deets/far-telemetry-v3/dual-sx1281-carrier-board/dual-sx1281-carrier-board.step

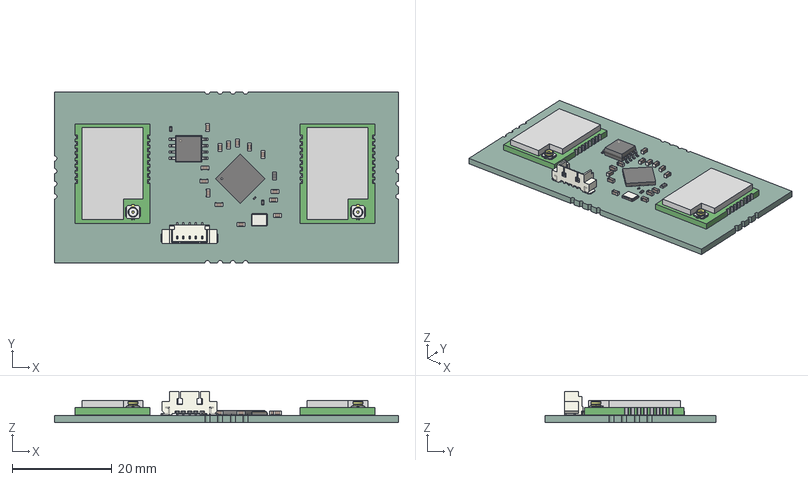
[picture p2: CAD file, 2026-10-22]
dual-sx1281-carrier-board/dual-sx1281-carrier-board.step
68.8 x 34.3 x 6.24 mm
C_0603_1608Metric x 14
Crystal_SMD_3225-4Pin_3.2x2.5mm
R_0402_1005Metric x 2
R_0603_1608Metric
QFN-56-1EP_7x7mm_P0.4mm_EP3.2x3.2mm
SOIC-8_5.3x5.3mm_P1.27mm
Folder 07 x 2
Linear Pattern 01 x 2
pads x 2
R_0201_0603Metric
Molex_53398_0571
dual-sx1281-carrier-board-unsaved-export-qZhUrT_PCB
