deets/far-telemetry-v3/dual-sx1281-carrier-board/dual-sx1281-carrier-board.kicad_pcb

## KiCad design dual-sx1281-carrier-board/dual-sx1281-carrier-board.kicad_pcb (2026-10-22)

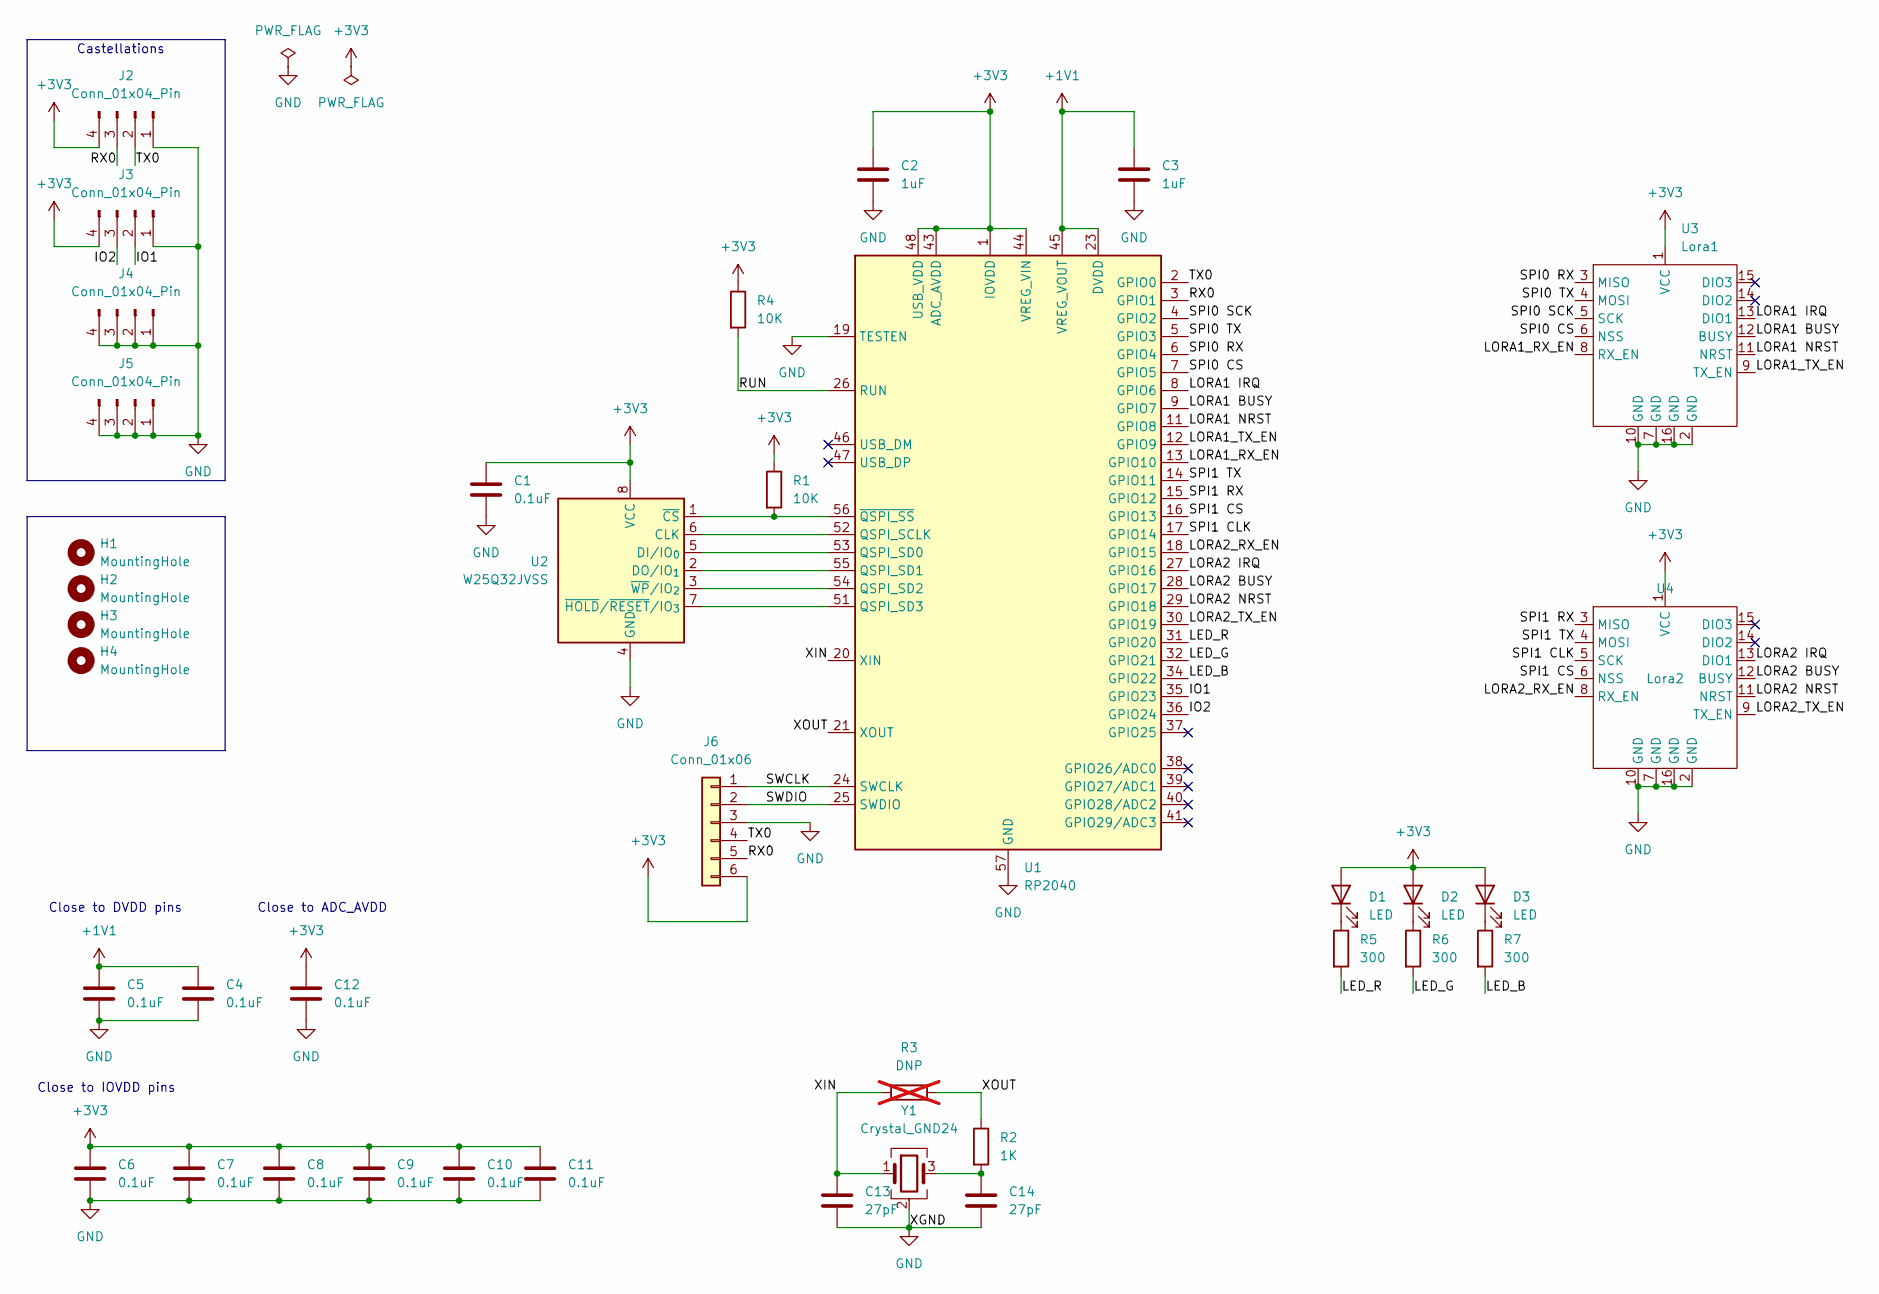
[picture p3: schematic dual-sx1281-carrier-board.kicad_sch]

Parts:
C1, C4, C5, C6, C7, C8, C9, C10, C11, C12: 0.1uF; C_0603_1608Metric
C2, C3: 1uF; C_0603_1608Metric
C13, C14: 27pF; C_0603_1608Metric
D1, D2, D3: LED; LED_0603_1608Metric
H1, H2, H3, H4: MountingHole; MountingHole_2mm
J2, J3, J4, J5: Conn_01x04_Pin; PinHeader_1x04_P2.54mm_Vertical
J6: Conn_01x06; Molex_PicoBlade_53398-0671_1x06-1MP_P1.25mm_Vertical
R1: 10K; R_0402_1005Metric
R2: 1K; R_0402_1005Metric
R3: DNP; R_0402_1005Metric; not fitted
R4: 10K; R_0603_1608Metric
R5, R6, R7: 300; R_0603_1608Metric
U1: RP2040; QFN-56-1EP_7x7mm_P0.4mm_EP3.2x3.2mm
U2: W25Q32JVSS; SOIC-8_5.3x5.3mm_P1.27mm
U3, U4: E28-2G4M20SX
Y1: Crystal_GND24; Crystal_SMD_3225-4Pin_3.2x2.5mm

Connections:
+1V1: C3.1, C4.1, C5.1, U1.23 (DVDD), U1.45 (VREG_VOUT), U1.50 (DVDD)
+3V3: C1.1, C2.1, C6.1, C7.1, C8.1, C9.1, C10.1, C11.1, C12.1, D1.2 (A), D2.2 (A), D3.2 (A), J2.4, J3.4, J6.6, R1.1, R4.1, U1.1 (IOVDD), U1.10 (IOVDD), U1.22 (IOVDD), U1.33 (IOVDD), U1.42 (IOVDD), U1.43 (ADC_AVDD), U1.44 (VREG_VIN), U1.48 (USB_VDD), U1.49 (IOVDD), U2.8 (VCC), U3.1 (VCC), U4.1 (VCC)
/IO1: J3.2, U1.35 (GPIO23)
/IO2: J3.3, U1.36 (GPIO24)
/LED_B: R7.2, U1.34 (GPIO22)
/LED_G: R6.2, U1.32 (GPIO21)
/LED_R: R5.2, U1.31 (GPIO20)
/LORA1 BUSY: U1.9 (GPIO7), U3.12 (BUSY)
/LORA1 IRQ: U1.8 (GPIO6), U3.13 (DIO1)
/LORA1 NRST: U1.11 (GPIO8), U3.11 (NRST)
/LORA1_RX_EN: U1.13 (GPIO10), U3.8 (RX_EN)
/LORA1_TX_EN: U1.12 (GPIO9), U3.9 (TX_EN)
/LORA2 BUSY: U1.28 (GPIO17), U4.12 (BUSY)
/LORA2 IRQ: U1.27 (GPIO16), U4.13 (DIO1)
/LORA2 NRST: U1.29 (GPIO18), U4.11 (NRST)
/LORA2_RX_EN: U1.18 (GPIO15), U4.8 (RX_EN)
/LORA2_TX_EN: U1.30 (GPIO19), U4.9 (TX_EN)
/RUN: R4.2, U1.26 (RUN)
/RX0: J2.3, J6.5, U1.3 (GPIO1)
/SPI0 CS: U1.7 (GPIO5), U3.6 (NSS)
/SPI0 RX: U1.6 (GPIO4), U3.3 (MISO)
/SPI0 SCK: U1.4 (GPIO2), U3.5 (SCK)
/SPI0 TX: U1.5 (GPIO3), U3.4 (MOSI)
/SPI1 CLK: U1.17 (GPIO14), U4.5 (SCK)
/SPI1 CS: U1.16 (GPIO13), U4.6 (NSS)
/SPI1 RX: U1.15 (GPIO12), U4.3 (MISO)
/SPI1 TX: U1.14 (GPIO11), U4.4 (MOSI)
/SWCLK: J6.1, U1.24 (SWCLK)
/SWDIO: J6.2, U1.25 (SWDIO)
/TX0: J2.2, J6.4, U1.2 (GPIO0)
/XIN: C13.1, R3.1, U1.20 (XIN), Y1.1
/XOUT: R2.1, R3.2, U1.21 (XOUT)
GND: C1.2, C2.2, C3.2, C4.2, C5.2, C6.2, C7.2, C8.2, C9.2, C10.2, C11.2, C12.2, C13.2, C14.2, J2.1, J3.1, J4.1, J4.2, J4.3, J4.4, J5.1, J5.2, J5.3, J5.4, J6.3, U1.19 (TESTEN), U1.57 (GND), U2.4 (GND), U3.2 (GND), U3.7 (GND), U3.10 (GND), U3.16 (GND), U4.2 (GND), U4.7 (GND), U4.10 (GND), U4.16 (GND), Y1.2 (G), Y1.4 (G)
unnamed: C14.1, R2.2, Y1.3
unnamed: D1.1 (K), R5.1
unnamed: D2.1 (K), R6.1
unnamed: D3.1 (K), R7.1
unnamed: U1.52 (QSPI_SCLK), U2.6 (CLK)
unnamed: U1.53 (QSPI_SD0), U2.5 (DI/IO_{0})
unnamed: U1.55 (QSPI_SD1), U2.2 (DO/IO_{1})
unnamed: U1.54 (QSPI_SD2), U2.3 (~WP/IO_{2})
unnamed: U1.51 (QSPI_SD3), U2.7 (~HOLD/~RESET/IO_{3})
unnamed: R1.2, U1.56 (~QSPI_SS), U2.1 (~CS)

Notes on the sheet:
Castellations
Close to ADC_AVDD
Close to DVDD pins
Close to IOVDD pins

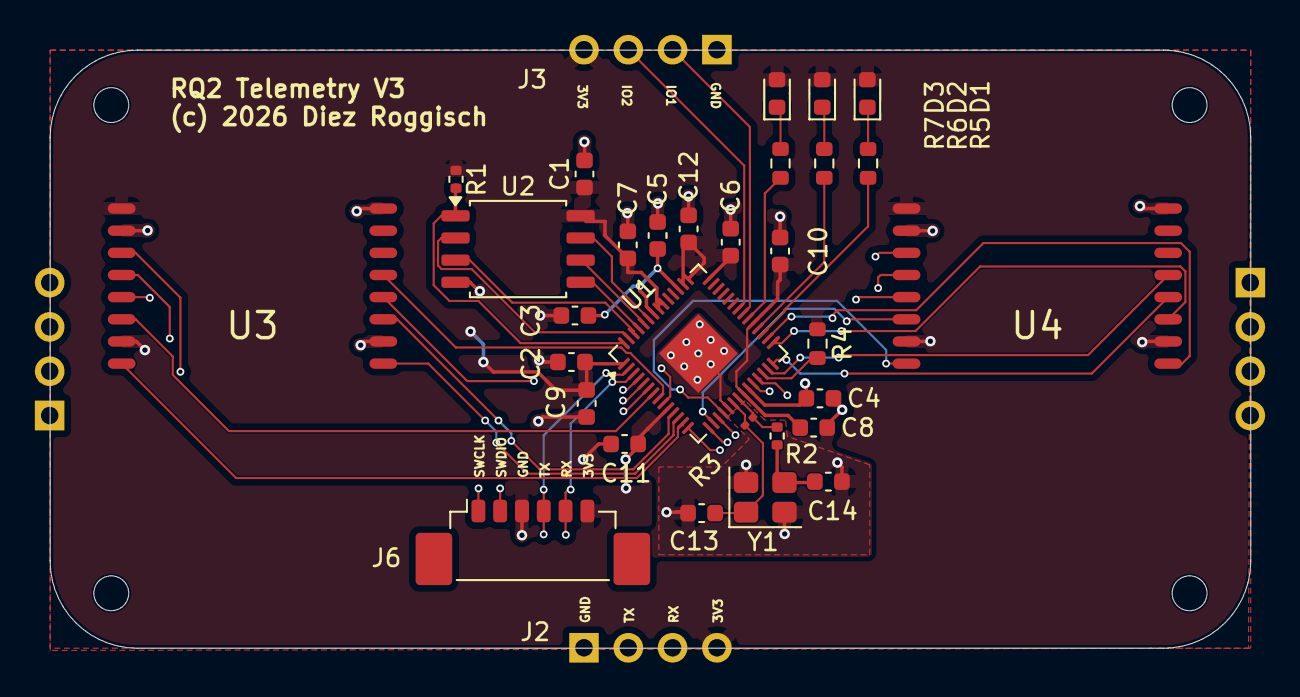
[picture p4: board dual-sx1281-carrier-board.kicad_pcb from above]

Board: 4 copper layers, 68.8 x 34.3 mm, 38 parts (0 on the bottom side), 43 nets.
