deets/far-telemetry-v3/dual-sx1281-carrier-board/rp2040-firmware/src/lib.rs

#![no_std]
use defmt::{debug, error, info};
use embassy_futures::select::select;
use embassy_rp::gpio::{Input, Output};
use embassy_rp::peripherals::{SPI0, SPI1};
use embassy_rp::spi::{Async, Spi};
use embassy_sync::blocking_mutex::raw::NoopRawMutex;
use embassy_sync::channel::{Channel, Receiver, Sender};
use embassy_time::Delay;
use embedded_hal_bus::spi::ExclusiveDevice;
use lora_phy::iv::GenericSx128xInterfaceVariant;
use lora_phy::mod_params::RadioError;
use lora_phy::mod_params::{SpreadingFactor, *};
use lora_phy::mod_traits::RadioKind;
use lora_phy::sx128x::{Sx1281, Sx128x};
use lora_phy::DelayNs;
use lora_phy::LoRa;
use rq2_telemetry_parser::{
    Bandwidth as Rq2Bandwidth, CodingRate as Rq2CodingRate, Command, ErrorCode, Mode, Module,
    Request, Response, SpreadingFactor as Rq2SpreadingFactor,
};
use static_cell::StaticCell;
use {defmt_rtt as _, panic_probe as _};

pub mod host_interface;

#[derive(Debug, PartialEq)]
enum Error {
    ConfigurationError,
    RadioError(RadioError),
}

#[derive(Debug)]
struct LoRaConfiguration {
    bandwidth: Bandwidth,
    spreading_factor: SpreadingFactor,
    coding_rate: CodingRate,
    frequency: usize,
    output_power: i32,
}

impl TryFrom<Request> for LoRaConfiguration {
    type Error = Error;

    fn try_from(value: Request) -> Result<Self, Self::Error> {
        match value {
            Request::Configure {
                bandwidth,
                spreading_factor,
                coding_rate,
                frequency,
                output_power,
            } => Ok(Self {
                bandwidth: bw_convert(bandwidth),
                spreading_factor: sf_convert(spreading_factor),
                coding_rate: cr_convert(coding_rate),
                frequency: frequency * 1000_000,
                output_power,
            }),
            _ => Err(Error::ConfigurationError),
        }
    }
}

struct LoraConfigurationManager<RK, DLY>
where
    RK: RadioKind,
    DLY: DelayNs,
{
    lora: LoRa<RK, DLY>,
    configuration: Option<LoRaConfiguration>,
    destination: Module,
}

struct LoraSendingManager<RK, DLY>
where
    RK: RadioKind,
    DLY: DelayNs,
{
    lora: LoRa<RK, DLY>,
    configuration: LoRaConfiguration,
    destination: Module,
    modulation_params: ModulationParams,
    tx_packet_params: PacketParams,
    output_power: i32,
}

struct LoraReceivingManager<RK, DLY>
where
    RK: RadioKind,
    DLY: DelayNs,
{
    lora: LoRa<RK, DLY>,
    configuration: LoRaConfiguration,
    destination: Module,
    rx_packet_params: PacketParams,
}

enum CommandResult<RK, DLY>
where
    RK: RadioKind,
    DLY: DelayNs,
{
    Configuration(LoraConfigurationManager<RK, DLY>),
    Sending(LoraSendingManager<RK, DLY>),
    Receiving(LoraReceivingManager<RK, DLY>),
}

impl From<RadioError> for Error {
    fn from(value: RadioError) -> Self {
        Self::RadioError(value)
    }
}

impl<RK, DLY> LoraSendingManager<RK, DLY>
where
    RK: RadioKind,
    DLY: DelayNs,
{
    async fn send(
        mut self,
        receiver: &mut CommandReceiver,
        sender: &mut Sender<'static, NoopRawMutex, Command, 4>,
        payload_receiver: &mut MessageReceiver,
    ) -> Result<LoraConfigurationManager<RK, DLY>, Error> {
        debug!("Start sending data");
        loop {
            match select(receiver.receive(), payload_receiver.receive()).await {
                embassy_futures::select::Either::First(command) => {
                    match command.payload {
                        rq2_telemetry_parser::Payload::Request {
                            command_id,
                            request,
                        } => match request {
                            Request::Ping => {
                                send_response(sender, self.destination, command_id, Response::Pong)
                                    .await?;
                            }
                            Request::Stop => {
                                info!(
                                    "Stopping sending: {:?}",
                                    defmt::Debug2Format(&self.destination)
                                );
                                send_response(sender, self.destination, command_id, Response::Ack)
                                    .await?;
                                break;
                            }
                            Request::Status => {
                                send_response(
                                    sender,
                                    self.destination,
                                    command_id,
                                    Response::Status(self.status()),
                                )
                                .await?;
                            }
                            _ => {
                                send_response(
                                    sender,
                                    self.destination,
                                    command_id,
                                    Response::Error(ErrorCode::InvalidCommand),
                                )
                                .await?;
                            }
                        },
                        // This is caught by the surrounding host interdace
                        data @ rq2_telemetry_parser::Payload::Data(..) => error!(
                            "Received invalid command: {:#?}",
                            defmt::Debug2Format(&data)
                        ),
                        response @ rq2_telemetry_parser::Payload::Response { .. } => {
                            error!(
                                "Received invalid command: {:#?}",
                                defmt::Debug2Format(&response)
                            );
                        }
                    }
                }
                embassy_futures::select::Either::Second(payload) => {
                    self.lora
                        .prepare_for_tx(
                            &self.modulation_params,
                            &mut self.tx_packet_params,
                            self.output_power,
                            &payload,
                        )
                        .await?;
                    self.lora.tx().await?;
                }
            }
        }
        LoraConfigurationManager::new_with_configuration(
            self.lora,
            self.destination,
            self.configuration,
        )
        .await
    }
}

impl<RK, DLY> LoraReceivingManager<RK, DLY>
where
    RK: RadioKind,
    DLY: DelayNs,
{
    async fn receive(
        mut self,
        receiver: &mut CommandReceiver,
        sender: &mut CommandSender,
        payload_sender: &mut MessageSender,
    ) -> Result<LoraConfigurationManager<RK, DLY>, Error> {
        debug!("Start receiving data");
        loop {
            let mut buffer = [0; 255];
            // See lora-phy/src/lib.rs:340 why I can't use do_rx
            self.lora.start_rx().await?;
            match select(receiver.receive(), self.lora.wait_for_irq()).await {
                embassy_futures::select::Either::First(command) => {
                    match command.payload {
                        rq2_telemetry_parser::Payload::Request {
                            command_id,
                            request,
                        } => match request {
                            Request::Ping => {
                                send_response(sender, self.destination, command_id, Response::Pong)
                                    .await?;
                            }
                            Request::Stop => {
                                info!(
                                    "Stopping receiving: {:?}",
                                    defmt::Debug2Format(&self.destination)
                                );
                                send_response(sender, self.destination, command_id, Response::Ack)
                                    .await?;
                                break;
                            }
                            Request::Status => {
                                send_response(
                                    sender,
                                    self.destination,
                                    command_id,
                                    Response::Status(self.status()),
                                )
                                .await?;
                            }
                            _ => {
                                send_response(
                                    sender,
                                    self.destination,
                                    command_id,
                                    Response::Error(ErrorCode::InvalidCommand),
                                )
                                .await?;
                            }
                        },
                        // This is caught by the surrounding host interdace
                        data @ rq2_telemetry_parser::Payload::Data(..) => error!(
                            "Received invalid command: {:#?}",
                            defmt::Debug2Format(&data)
                        ),
                        response @ rq2_telemetry_parser::Payload::Response { .. } => {
                            error!(
                                "Received invalid command: {:#?}",
                                defmt::Debug2Format(&response)
                            );
                        }
                    }
                }
                embassy_futures::select::Either::Second(r) => match r {
                    Ok(_) => {
                        match self
                            .lora
                            .complete_rx(&self.rx_packet_params, &mut buffer)
                            .await
                        {
                            Ok((len, ..)) => {
                                let mut message: MessageType = MessageType::new();
                                match message.extend_from_slice(&buffer[0..len as usize]) {
                                    Ok(_) => match payload_sender.try_send(message) {
                                        Ok(_) => {}
                                        Err(_) => error!("Can't send payload, discarding"),
                                    },
                                    Err(_) => todo!(),
                                }
                            }
                            Err(e) => {
                                error!("complete_rx failed: {:#?}", defmt::Debug2Format(&e));
                                break;
                            }
                        }
                    }
                    Err(e) => {
                        error!(
                            "error {:#?} waiting for irq on {:?}",
                            defmt::Debug2Format(&e),
                            defmt::Debug2Format(&self.destination)
                        );
                        break;
                    }
                },
            }
        }
        LoraConfigurationManager::new_with_configuration(
            self.lora,
            self.destination,
            self.configuration,
        )
        .await
    }
}

impl<RK, DLY> LoraConfigurationManager<RK, DLY>
where
    RK: RadioKind,
    DLY: DelayNs,
{
    async fn new(mut lora: LoRa<RK, DLY>, destination: Module) -> Result<Self, Error> {
        lora.init().await?;
        Ok(Self {
            lora,
            destination,
            configuration: None,
        })
    }

    async fn new_with_configuration(
        lora: LoRa<RK, DLY>,
        destination: Module,
        configuration: LoRaConfiguration,
    ) -> Result<Self, Error> {
        let mut manager = Self::new(lora, destination).await?;
        manager.configuration = Some(configuration);
        Ok(manager)
    }

    fn set_configuration(&mut self, request: Request) -> Result<(), Error> {
        let configuration = request.try_into()?;
        self.configuration = Some(configuration);
        Ok(())
    }

    async fn start_sending(
        mut self,
        sender: &mut CommandSender,
        command_id: u8,
    ) -> Result<CommandResult<RK, DLY>, Error> {
        if let Some(
            configuration @ LoRaConfiguration {
                bandwidth,
                spreading_factor,
                coding_rate,
                frequency,
                output_power,
            },
        ) = self.configuration
        {
            let modulation_params = self.lora.create_modulation_params(
                spreading_factor,
                bandwidth,
                coding_rate,
                frequency as u32,
            )?;
            let tx_packet_params =
                self.lora
                    .create_tx_packet_params(4, false, true, true, &modulation_params)?;

            send_response(sender, self.destination, command_id, Response::Ack).await?;
            Ok(CommandResult::Sending(LoraSendingManager {
                configuration,
                lora: self.lora,
                destination: self.destination,
                modulation_params,
                tx_packet_params,
                output_power,
            }))
        } else {
            let response = Response::Error(ErrorCode::NoConfiguration);
            send_response(sender, self.destination, command_id, response).await?;
            Ok(CommandResult::Configuration(self))
        }
    }

    async fn start_receiving(
        mut self,
        sender: &mut CommandSender,
        command_id: u8,
    ) -> Result<CommandResult<RK, DLY>, Error> {
        if let Some(
            configuration @ LoRaConfiguration {
                bandwidth,
                spreading_factor,
                coding_rate,
                frequency,
                ..
            },
        ) = self.configuration
        {
            let modulation_params = self.lora.create_modulation_params(
                spreading_factor,
                bandwidth,
                coding_rate,
                frequency as u32,
            )?;
            let rx_packet_params =
                self.lora
                    .create_rx_packet_params(4, false, 140, true, true, &modulation_params)?;

            self.lora
                .prepare_for_rx(RxMode::Continuous, &modulation_params, &rx_packet_params)
                .await?;

            send_response(sender, self.destination, command_id, Response::Ack).await?;
            Ok(CommandResult::Receiving(LoraReceivingManager {
                configuration,
                lora: self.lora,
                destination: self.destination,
                rx_packet_params,
            }))
        } else {
            let response = Response::Error(ErrorCode::NoConfiguration);
            send_response(sender, self.destination, command_id, response).await?;
            Ok(CommandResult::Configuration(self))
        }
    }

    async fn process_command(
        mut self,
        sender: &mut CommandSender,
        command: Command,
    ) -> Result<CommandResult<RK, DLY>, Error> {
        match command.payload {
            rq2_telemetry_parser::Payload::Request {
                command_id,
                request,
            } => match request {
                Request::Ping => {
                    debug!("ping for {:#?}", defmt::Debug2Format(&self.destination));
                    send_response(sender, self.destination, command_id, Response::Pong).await?;
                    Ok(CommandResult::Configuration(self))
                }
                Request::Status => {
                    send_response(
                        sender,
                        self.destination,
                        command_id,
                        Response::Status(self.status()),
                    )
                    .await?;
                    Ok(CommandResult::Configuration(self))
                }
                Request::Configure { .. } => {
                    send_response(
                        sender,
                        self.destination,
                        command_id,
                        match self.set_configuration(request) {
                            Ok(_) => Response::Ack,
                            Err(_) => Response::Error(ErrorCode::CantSetConfiguration),
                        },
                    )
                    .await?;
                    Ok(CommandResult::Configuration(self))
                }
                Request::Stop => {
                    send_response(
                        sender,
                        self.destination,
                        command_id,
                        Response::Error(ErrorCode::InvalidCommand),
                    )
                    .await?;
                    Ok(CommandResult::Configuration(self))
                }
                Request::Send => self.start_sending(sender, command_id).await,
                Request::Receive => self.start_receiving(sender, command_id).await,
            },
            _ => {
                error!(
                    "Received unexpected command: {:#?}",
                    defmt::Debug2Format(&command)
                );
                Ok(CommandResult::Configuration(self))
            }
        }
    }
}

trait HasStatus {
    fn status(&self) -> Mode;
}

impl<RK, DLY> HasStatus for LoraConfigurationManager<RK, DLY>
where
    RK: RadioKind,
    DLY: DelayNs,
{
    fn status(&self) -> Mode {
        Mode::Idle
    }
}

impl<RK, DLY> HasStatus for LoraSendingManager<RK, DLY>
where
    RK: RadioKind,
    DLY: DelayNs,
{
    fn status(&self) -> Mode {
        Mode::Tx
    }
}

impl<RK, DLY> HasStatus for LoraReceivingManager<RK, DLY>
where
    RK: RadioKind,
    DLY: DelayNs,
{
    fn status(&self) -> Mode {
        Mode::RxContinuous
    }
}

async fn send_response(
    sender: &mut CommandSender,
    destination: rq2_telemetry_parser::Module,
    command_id: u8,
    response: Response,
) -> Result<(), Error> {
    let response = Command {
        destination,
        payload: rq2_telemetry_parser::Payload::Response {
            command_id,
            response,
        },
    };
    sender.send(response).await;
    Ok(())
}

async fn lora_work<RK: RadioKind, DLY: DelayNs>(
    mut manager: LoraConfigurationManager<RK, DLY>,
    mut receiver: CommandReceiver,
    mut sender: CommandSender,
    mut payload_receiver: MessageReceiver,
    mut payload_sender: MessageSender,
) -> Result<(), Error> {
    loop {
        let command = receiver.receive().await;
        manager = match manager.process_command(&mut sender, command).await? {
            CommandResult::Configuration(lora_configuration_manager) => lora_configuration_manager,
            CommandResult::Sending(lora_sending_manager) => {
                lora_sending_manager
                    .send(&mut receiver, &mut sender, &mut payload_receiver)
                    .await?
            }
            CommandResult::Receiving(lora_receiving_manager) => {
                lora_receiving_manager
                    .receive(&mut receiver, &mut sender, &mut payload_sender)
                    .await?
            }
        };
    }
}

#[embassy_executor::task]
pub async fn lora1_task(
    lora1: LoRa<
        Sx128x<
            ExclusiveDevice<Spi<'static, SPI0, Async>, Output<'static>, Delay>,
            GenericSx128xInterfaceVariant<Output<'static>, Input<'static>>,
            Sx1281,
        >,
        Delay,
    >,
    receiver: CommandReceiver,
    sender: CommandSender,
    payload_receiver: MessageReceiver,
    payload_sender: MessageSender,
) {
    let manager = LoraConfigurationManager::new(lora1, Module::Lora1)
        .await
        .expect("Can't init Lora1-Module");

    match lora_work(manager, receiver, sender, payload_receiver, payload_sender).await {
        Ok(_) => {}
        Err(e) => {
            error!(
                "error working with module, halting: {:#?}",
                defmt::Debug2Format(&e)
            );
        }
    }
}

#[embassy_executor::task]
pub async fn lora2_task(
    lora2: LoRa<
        Sx128x<
            ExclusiveDevice<Spi<'static, SPI1, Async>, Output<'static>, Delay>,
            GenericSx128xInterfaceVariant<Output<'static>, Input<'static>>,
            Sx1281,
        >,
        Delay,
    >,
    receiver: CommandReceiver,
    sender: CommandSender,
    payload_receiver: MessageReceiver,
    payload_sender: MessageSender,
) {
    let manager = LoraConfigurationManager::new(lora2, Module::Lora2)
        .await
        .expect("Can't init Lora2-Module");

    match lora_work(manager, receiver, sender, payload_receiver, payload_sender).await {
        Ok(_) => {}
        Err(e) => {
            error!(
                "error working with module, halting: {:#?}",
                defmt::Debug2Format(&e)
            );
        }
    }
}

fn sf_convert(spreading_factor: Rq2SpreadingFactor) -> SpreadingFactor {
    match spreading_factor {
        Rq2SpreadingFactor::_6 => SpreadingFactor::_6,
        Rq2SpreadingFactor::_7 => SpreadingFactor::_7,
        Rq2SpreadingFactor::_8 => SpreadingFactor::_8,
        Rq2SpreadingFactor::_9 => SpreadingFactor::_9,
        Rq2SpreadingFactor::_10 => SpreadingFactor::_10,
        Rq2SpreadingFactor::_11 => SpreadingFactor::_11,
        Rq2SpreadingFactor::_12 => SpreadingFactor::_12,
    }
}
fn bw_convert(bandwidth: Rq2Bandwidth) -> Bandwidth {
    match bandwidth {
        Rq2Bandwidth::_200KHz => Bandwidth::_200KHz,
        Rq2Bandwidth::_400KHz => Bandwidth::_400KHz,
        Rq2Bandwidth::_800KHz => Bandwidth::_800KHz,
        Rq2Bandwidth::_1600KHz => Bandwidth::_1600KHz,
    }
}

fn cr_convert(coding_rate: Rq2CodingRate) -> CodingRate {
    match coding_rate {
        Rq2CodingRate::_4_5 => CodingRate::_4_5,
        Rq2CodingRate::_4_6 => CodingRate::_4_6,
        Rq2CodingRate::_4_7 => CodingRate::_4_7,
        Rq2CodingRate::_4_8 => CodingRate::_4_8,
    }
}
pub type MessageType = heapless::Vec<u8, 128>;
pub type CommandChannel = Channel<NoopRawMutex, Command, 4>;
pub type PayloadChannel = Channel<NoopRawMutex, MessageType, 4>;

type CommandReceiver = Receiver<'static, NoopRawMutex, Command, 4>;
type CommandSender = Sender<'static, NoopRawMutex, Command, 4>;
type MessageReceiver = Receiver<'static, NoopRawMutex, MessageType, 4>;
type MessageSender = Sender<'static, NoopRawMutex, MessageType, 4>;

pub static LORA1_SEND_CHANNEL: StaticCell<CommandChannel> = StaticCell::new();
pub static LORA1_RECEIVE_CHANNEL: StaticCell<CommandChannel> = StaticCell::new();
pub static LORA2_SEND_CHANNEL: StaticCell<CommandChannel> = StaticCell::new();
pub static LORA2_RECEIVE_CHANNEL: StaticCell<CommandChannel> = StaticCell::new();

pub static LORA1_PAYLOAD_SEND_CHANNEL: StaticCell<PayloadChannel> = StaticCell::new();
pub static LORA1_PAYLOAD_RECEIVE_CHANNEL: StaticCell<PayloadChannel> = StaticCell::new();
pub static LORA2_PAYLOAD_SEND_CHANNEL: StaticCell<PayloadChannel> = StaticCell::new();
pub static LORA2_PAYLOAD_RECEIVE_CHANNEL: StaticCell<PayloadChannel> = StaticCell::new();
