deets/far-telemetry-v3/SX128x_Transmit_Blocking/arduino/arduino.cpp

#include "Arduino.h"

#include <sstream>
#include <optional>


enum class BusyPin { Nop, Low, High };

static uint32_t s_busy_pin = -1;
static uint32_t s_irq_pin = -1;
static BusyPin s_fake_busy = BusyPin::Nop;
static uint16_t s_irq_mask = 0;

void delay(int) {}


std::string to_string(int v, int base) {
  std::stringstream ss;
  ss << v;
  return ss.str();
}

String::String(int v, int base) : std::string(to_string(v, base)) {
}

String operator+(const char * l, const String & r) {
  std::stringstream ss;
  ss << l << r;
  const auto s = ss.str();
  return String(s.begin(), s.end());
}


char pgm_read_byte(const char *p) {
  return *p;
}


void pinMode(uint32_t, int) {}
void digitalWrite(uint32_t, int) {}
int digitalRead(uint32_t pin) {
  if (pin == s_busy_pin) {
    switch (s_fake_busy) {
    case BusyPin::Nop:
      return 0;
    case BusyPin::Low:
      s_fake_busy = BusyPin::High;
      return 0;
    case BusyPin::High:
      s_fake_busy = BusyPin::Nop;
      return 1;
    }
  }
  if (pin == s_irq_pin && s_irq_mask) {
    return 1;
  }
  return 0;
  }
void attachInterrupt(int, void (*)(void), uint32_t) {}
void detachInterrupt(int) {}
long pulseIn(uint32_t pin, uint32_t state, uint32_t timeout) {
  return -1;
}
void tone(uint32_t pin, unsigned int frequency, uint32_t duration) {}
void noTone(uint32_t pin) {}
void yield() {}
uint32_t digitalPinToInterrupt(uint32_t pin) { return pin; }

unsigned long millis() { return 0;}
unsigned long micros() { return 0;}
void delayMicroseconds(int us) {}



void declareBusyPin(int pin) {
  s_busy_pin = pin;
}

void declareIrqPin(int pin) {
  s_irq_pin = pin;
}

void fakeBusy() {
  s_fake_busy = BusyPin::High;
}

void setIrqMask(uint16_t mask) {
  s_irq_mask = mask;
}

uint16_t getIrqMask() {
  return s_irq_mask;
}
