deets/far-telemetry-v3/(commit log)

2026-10-22 Empty carrier board project
2026-10-22 Start recording and printing the C++ transactions
2026-10-22 We can print now..
2026-10-22 Move printing code into cpp
2026-10-22 PCB fully routed
2026-10-22 Added host interface task talking via UART
2026-10-22 Start working on the UART framing
2026-10-22 Reworked the whole shebang to be less coupled
    Sending pong seems to work, now just needs processing
2026-10-22 Introduce error codes coming from the device
2026-10-22 Scaffolding for switch to sending behavior in place
2026-10-22 Silkscreen and nice PCB image for docs
2026-10-23 Split up rx to allow for it to be interrupted
