deets/far-telemetry-v3/(notices)

Notices in the files:
dual-sx1281-carrier-board/dual-sx1281-carrier-board.kicad_pcb:
(c) 2026 Diez Roggisch
